kawdoco/line_following_aura/(commit log)

2026-05-17 Pin layout SVG-assets
2026-05-17 Add hardware overview section to README
    Added a hardware overview section detailing the power system, ESP32 configuration, motor driver, and sensor setup.
2026-05-17 ESP32 OTA + WiFi setup + gitignore setup
2026-05-18 Switch from WiFi OTA control flow to web server based OTA system
2026-05-18 Add BLE PID controller web app
2026-05-21 add sensor calibration system with auto-calibration routine
2026-05-22 enhance auto-calibration accuracy
2026-05-22 add position filtering and line following
2026-05-22 fixed fake turn issue on curves and overshoot issue
    [main_code.ino]
2026-05-22 fix BLE app pid max values
2026-05-22 fix over shoot at L turns issue
    [main_code.ino]
2026-05-23 fix: replace lookahead with reactive two way turn check for corner detection algorithm
    [main_code.ino]
2026-05-24 revert: from snap-turn back to lookahead edge detection
    [main_code.ino]
2026-05-30 Add I2C oled display animations
